Engipony/Electric_Con_Badges/Eagle Files/BCProjectBoardV2.sch

## EAGLE design Eagle Files/BCProjectBoardV2.sch (2019-09-04)

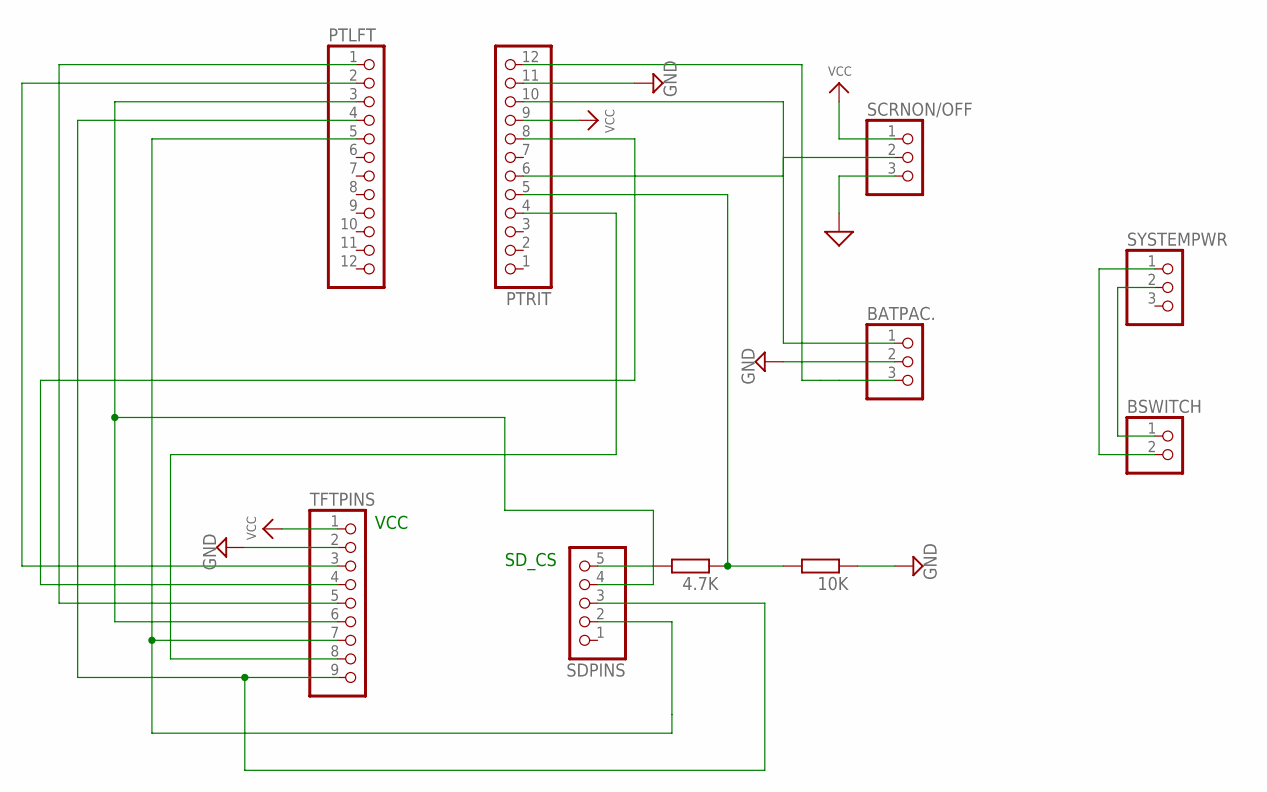
[picture p1: schematic BCProjectBoardV2.sch]

Parts:
4.7K, 10K: R-EU_0204/5; 0204/5
BATPAC.: PINHD-1X3; 1X03
BSWITCH: PINHD-1X2; 1X02
PTLFT: PINHD-1X12; 1X12
PTRIT: PINHD-1X12; 1X12
SCRNON/OFF: PINHD-1X3; 1X03
SDPINS: PINHD-1X5; 1X05
SYSTEMPWR: PINHD-1X3; 1X03
TFTPINS: PINHD-1X9; 1X09

Connections:
GND: 10K.1, BATPAC..2, PTRIT.11, SCRNON/OFF.3, TFTPINS.2
unnamed: 4.7K.2, SDPINS.5
unnamed: 4.7K.1, 10K.2, PTRIT.5
unnamed: PTLFT.4, SDPINS.3, TFTPINS.9
unnamed: PTRIT.4, TFTPINS.8
unnamed: PTLFT.5, SDPINS.2, TFTPINS.7
unnamed: PTLFT.3, SDPINS.4, TFTPINS.6
unnamed: PTLFT.1, TFTPINS.5
unnamed: PTRIT.8, TFTPINS.4
unnamed: PTLFT.2, TFTPINS.3
unnamed: PTRIT.6, SCRNON/OFF.2
unnamed: BSWITCH.1, SYSTEMPWR.2
unnamed: BSWITCH.2, SYSTEMPWR.1
unnamed: BATPAC..3, PTRIT.12
unnamed: BATPAC..1, PTRIT.10
VCC: PTRIT.9, SCRNON/OFF.1, TFTPINS.1

Notes on the sheet:
SD_CS
VCC
