Engipony/Electric_Con_Badges/(commit log)

2019-09-04 There are the GERBER files for the badge
    Just send these to JLCPCB and match the file name to the layers (I used the default eagle output for these) and select the 5 prototype boards option. You should be able to get them made for $2 with some like overpriced shipping added to that.
2019-09-04 These are the Eagle files for the board.
    Open these in Eagle to change literally anything you want about the board design. There are plenty of things that could be improved with this design so make any changes you see fit.
    [BCProjectBoardV2.sch]
